ecstoneusps/Claude-gadget/sdcard/settings.txt

# Desk Buddy settings
#
# Edit this file on your computer, put the card back in, and restart the
# buddy (or unplug it and plug it back in). Anything after # is a comment.
# Delete a line, or the whole file, to go back to the built-in default.
# Mistakes are shown in the serial log and that line is ignored.

# --- Sound and screen ---
volume                       = 63     # speaker volume, 0-100 ("be quiet" still mutes it)
sound_style                  = puppy  # puppy (yips, barks, panting) or robot (chirps, boops); sounds/<name>.wav on the card replaces one
brightness                   = 63     # screen brightness, 0-100
screen_flip                  = on     # on: CoreS3 turned around in the puppy head (camera at the top)
dim_brightness               = 8      # brightness while dozing, 0-100

# --- Sleepiness ---
sleep_after_seconds          = 60     # doze off after this long with nothing happening
dim_after_seconds            = 180    # dim the screen after this long
sleep_after_leaving_seconds  = 20     # doze sooner once you walk away

# --- Voice ---
command_confidence           = 0      # 0-1; raise to 0.3 or so if it reacts to things you didn't say
two_microphones              = off    # both mics: hears you better over noise, but slows everything else down

# Extra ways to say a command, separated by commas. Letters and spaces only.
# Remove the # in front of a line to use it. Commands you can add to:
#  say.hello  say.good_night  say.wake_up  say.how_are_you  say.i_love_you
#  say.good_job  say.scold  say.thank_you  say.tell_joke  say.look_left
#  say.look_right  say.be_happy  say.be_sad  say.be_angry  say.be_surprised
#  say.be_quiet  say.sound_on  say.wink  say.be_cool  say.be_silly
#  say.volume_up  say.volume_down  say.take_picture  say.look_at_this
# say.hello = howdy, whats up buddy
# say.good_night = nighty night

# --- Camera ---
face_tracking                = on     # eyes follow your face
camera_mirrored              = off    # flip (on/off) if the eyes look away from you instead of at you
face_gaze                    = 1.4    # how far the eyes turn toward you, 0-3
face_model                   = fast   # fast checks ~14 times a second; accurate finds you more often per check but is ~7x slower
photo_flash                  = off    # screen lights up white for photos (brighter close-ups; shiny things reflect)
camera_preview               = off    # show what the camera sees (green box = face found) instead of the face

# --- Proximity sensor (above the screen) ---
proximity                    = on     # wake up when you sit down
proximity_sensitivity        = 25     # lower notices you from further away (but more false alarms)

# --- Presence radar (LD2410, plugged into Port C) ---
radar                        = on     # use the radar when one is plugged in (instead of the proximity sensor)
radar_distance_cm            = 150    # how close (cm) counts as sitting at the desk, 30-600

# --- Motion ---
flip_tilt_x                  = off    # turn on if tilting left/right makes the eyes go the wrong way
flip_tilt_y                  = off    # same for tilting forward/back

# --- Talking with the AI (through Home Assistant) ---
# Fill in all four to talk to Buddy's AI. Put "quotes" around the password
# if it has a # in it. Keep this card private: the token is a password.
wifi_name                    =        # your home Wi-Fi network (2.4 GHz)
wifi_password                =        # its password
wifi_name_2                  =        # optional: another network if home isn't in range, e.g. your phone's hotspot
wifi_password_2              =        # its password
wifi_name_3                  =        # optional: a third network, tried after the second
wifi_password_3              =        # its password
setup_hotspot                = on     # no network works for 2 min: open Wi-Fi "Buddy Setup" for the settings page
ha_url                       =        # Home Assistant's address at home, e.g. http://192.168.1.20:8123
ha_url_away                  =        # optional: its address from anywhere else, e.g. a Tailscale Funnel https://...ts.net
ha_token                     =        # long-lived access token (from the Desk Buddy user)
ha_pipeline                  = Buddy  # name of the voice assistant in Home Assistant
conversation                 = on     # off = only the built-in commands
follow_up                    = on     # keep listening after an answer, no "Hey Buddy" needed
memory                       = on     # "remember that ..." notes, kept in memories.txt and told to the AI
learn                        = on     # after a chat, the AI adds lasting facts it heard to memories.txt (check them on the settings page)
voice_id_url                 =        # optional: voice recognition on the PC (tools/voiceid), e.g. http://192.168.1.30:8095
welcome_back_minutes         = 20     # say hello out loud when you come back after this long away (0 = off)

# --- Home Assistant sensors and controls (MQTT, through the Mosquitto add-on) ---
# Buddy shows up in Home Assistant as the device "Desk Buddy": at desk, light level,
# mood..., plus volume, "say" and more. Home network only.
mqtt_url                     =        # the broker, e.g. mqtt://192.168.1.20:1883 (Home Assistant's address)
mqtt_user                    =        # an MQTT login (a Home Assistant user works)
mqtt_password                =        # its password

# --- Seeing ("what do you see?", "what am I holding?") ---
# Photos go straight to a vision model in Ollama on your PC; the answer is
# spoken through Home Assistant. Install it first: ollama pull gemma3:4b
vision_url                   =        # Ollama's address, e.g. http://192.168.1.30:11434
vision_model                 = gemma3:4b # a vision model you've pulled in Ollama
