ecstoneusps/Claude-gadget/hardware/puppy/images/paws.png

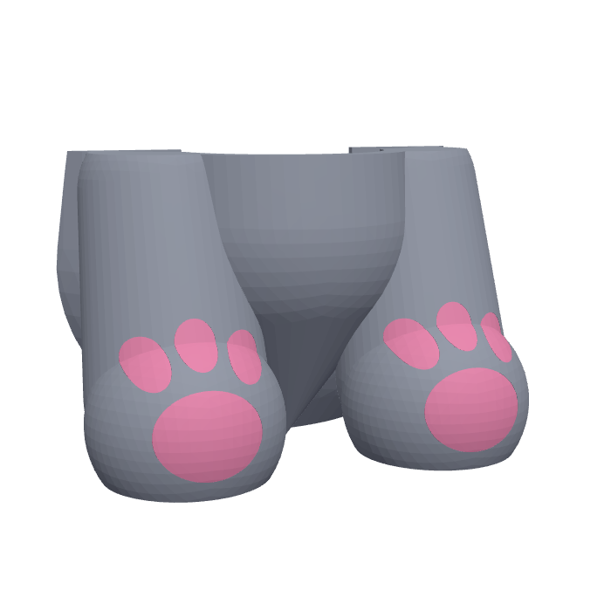
hardware/puppy/images/paws.png
