ecstoneusps/Claude-gadget/preview/face_anim.gif

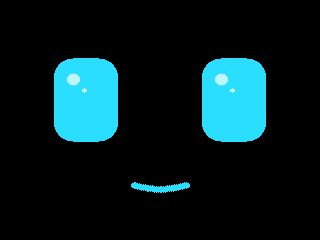
preview/face_anim.gif
