ecstoneusps/Claude-gadget/hardware/puppy/stl/buddy_body.stl

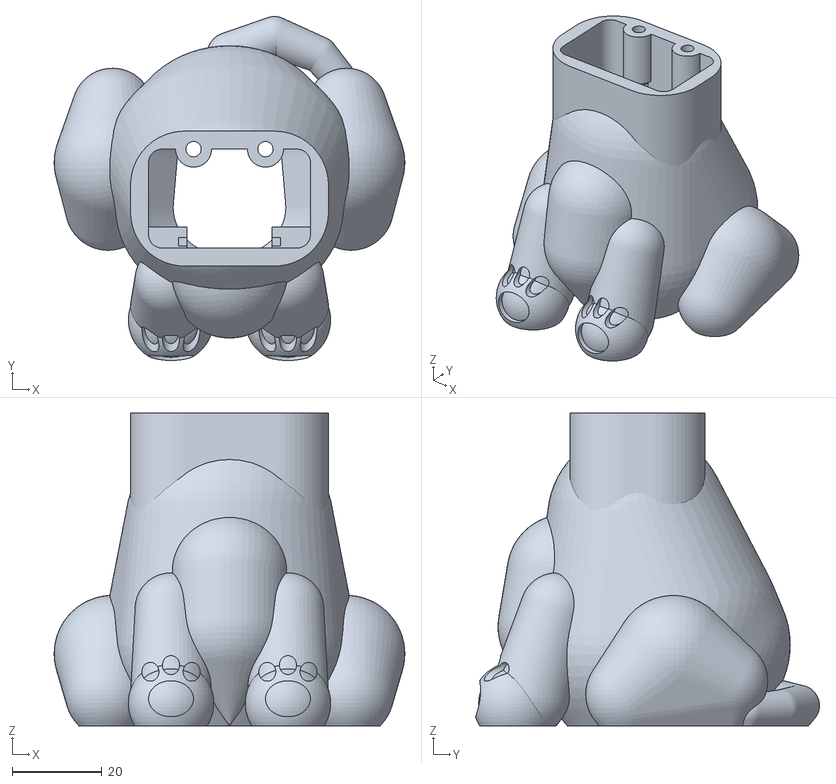
[picture p9: CAD file, 2026-11-09]
hardware/puppy/stl/buddy_body.stl
78.0 x 76.5 x 69.5
