ecstoneusps/Claude-gadget/hardware/puppy/stl/buddy_back_cap.stl

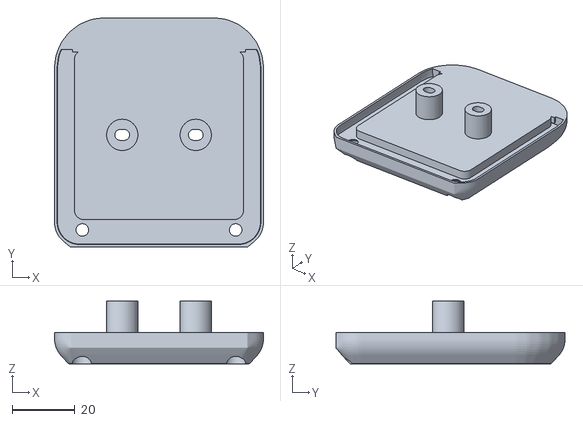
[picture p10: CAD file, 2026-11-09]
hardware/puppy/stl/buddy_back_cap.stl
66.8 x 73.3 x 20.0
