ecstoneusps/Claude-gadget/hardware/puppy/stl/buddy_body_pink.stl

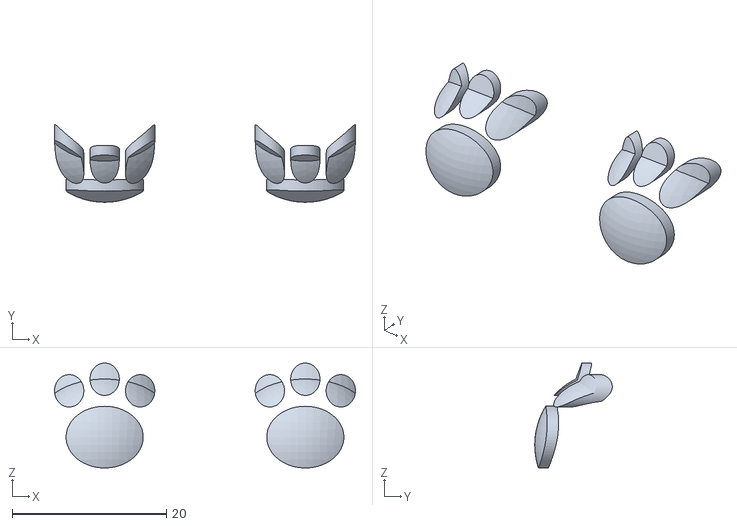
[picture p11: CAD file, 2026-11-09]
hardware/puppy/stl/buddy_body_pink.stl
39.0 x 10.1 x 13.6
