ecstoneusps/Claude-gadget/hardware/puppy/stl/buddy_head.stl

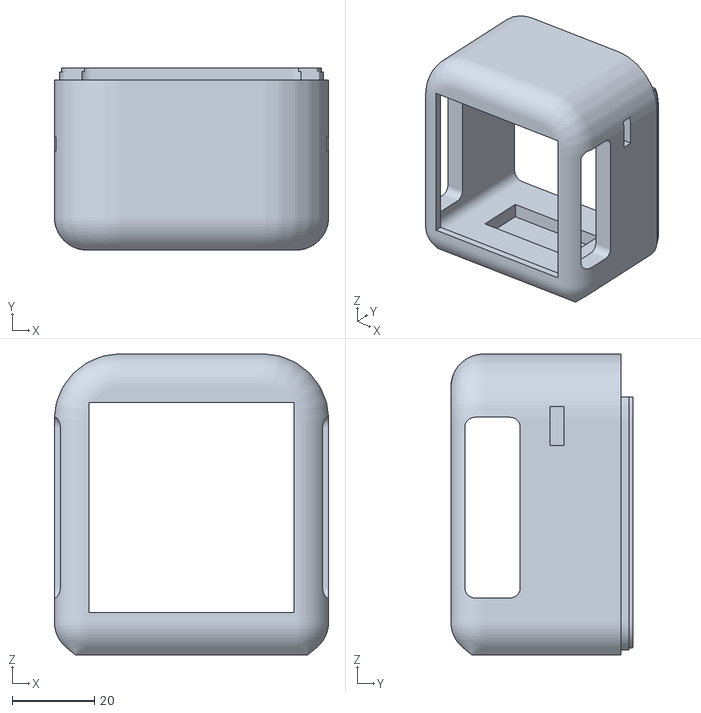
[picture p12: CAD file, 2026-11-09]
hardware/puppy/stl/buddy_head.stl
66.8 x 44.4 x 73.3
