ecstoneusps/Claude-gadget/hardware/puppy/stl/buddy_ear_left.stl

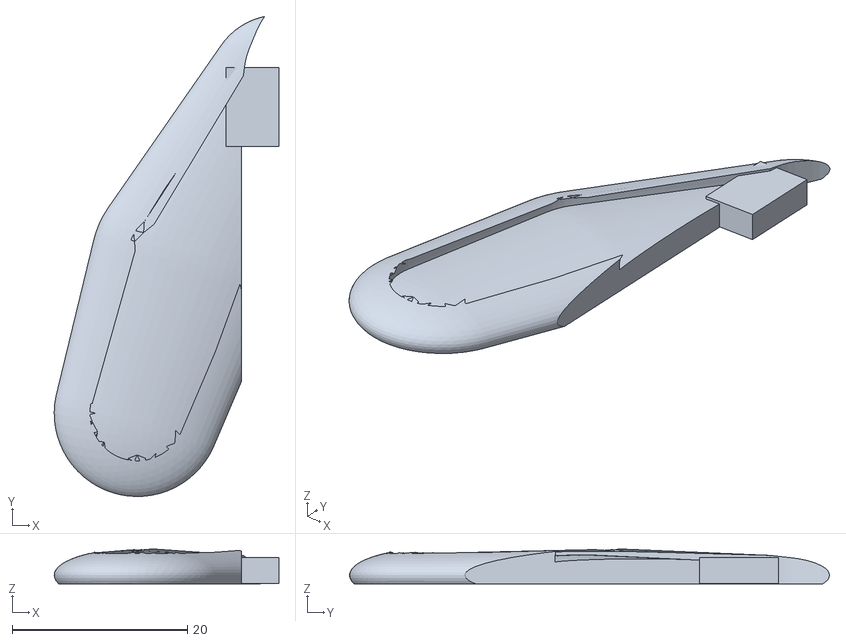
[picture p13: CAD file, 2026-11-09]
hardware/puppy/stl/buddy_ear_left.stl
25.6 x 54.8 x 3.99
