ecstoneusps/Claude-gadget/hardware/puppy/stl/buddy_ear_right.stl

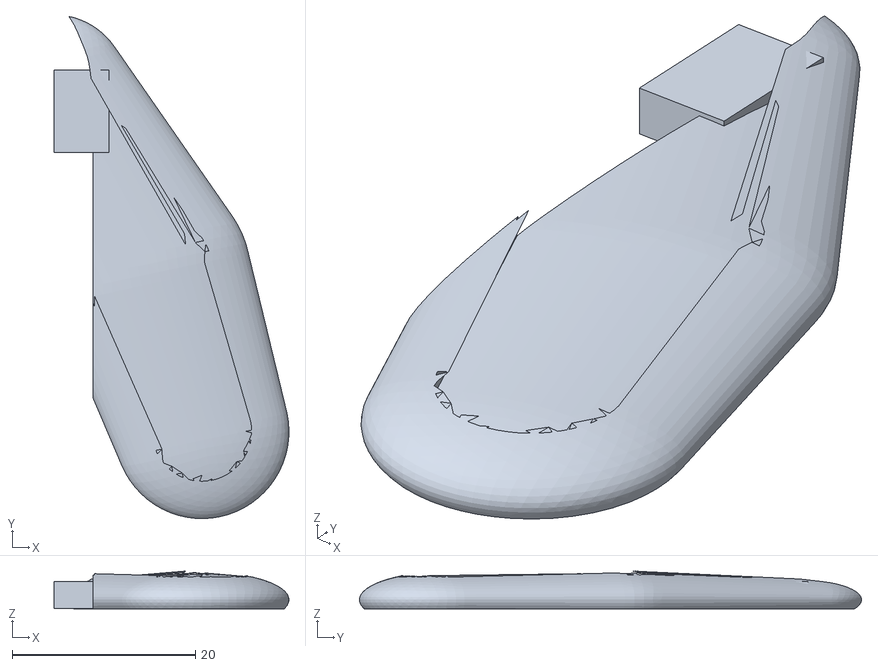
[picture p14: CAD file, 2026-11-09]
hardware/puppy/stl/buddy_ear_right.stl
25.6 x 54.8 x 4.13
