ecstoneusps/Claude-gadget/hardware/puppy/stl/buddy_ear_right_pink.stl

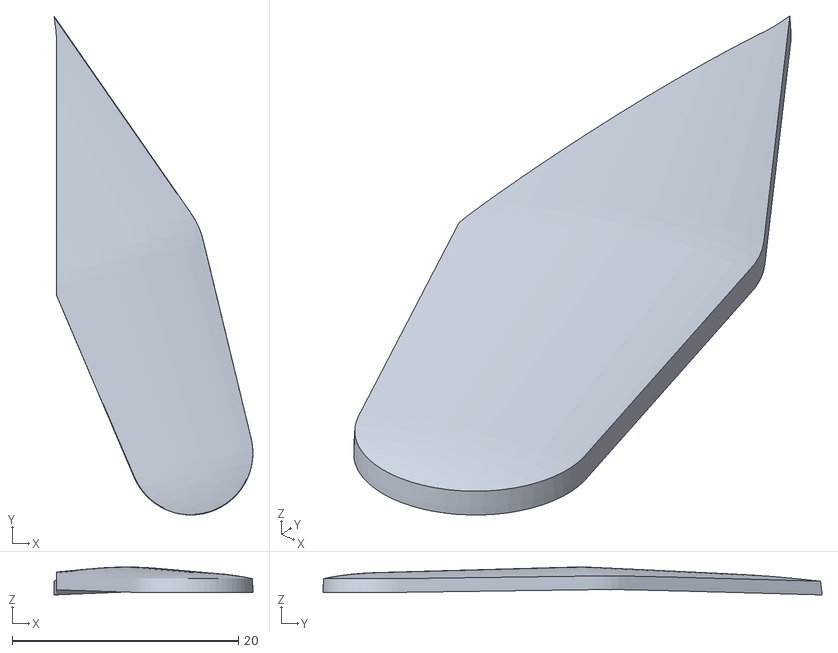
[picture p15: CAD file, 2026-11-09]
hardware/puppy/stl/buddy_ear_right_pink.stl
17.6 x 44.1 x 2.47
