ecstoneusps/Claude-gadget/(list of files, cad)

Other CAD files:
hardware/puppy/stl/buddy_ear_left_pink.stl
