ecstoneusps/Claude-gadget/main/camera.cpp

#include "camera.h"

#include <atomic>

#include <M5Unified.h>
#include "esp_camera.h"
#include "esp_log.h"
#include "esp_timer.h"
#include "esp_heap_caps.h"
#include "freertos/semphr.h"
#include <string.h>
#include "freertos/FreeRTOS.h"
#include "freertos/task.h"
#include "freertos/idf_additions.h"

#include "human_face_detect.hpp"
#include "img_converters.h"
#include "i2c_bus.h"

static const char* TAG = "camera";

// GC0308 wiring on the CoreS3, from M5Stack's CoreS3 library
// (github.com/m5stack/M5CoreS3, src/utility/GC0308.cpp).
static camera_config_t makeConfig(framesize_t size = FRAMESIZE_QQVGA, int fbCount = 2) {
    camera_config_t c = {};
    c.pin_pwdn = -1;
    c.pin_reset = -1;
    c.pin_xclk = -1;  // the CoreS3 clocks the sensor itself
    c.pin_sccb_sda = -1;  // -1: reuse the already-open internal I2C bus (see i2c_bus.h)
    c.pin_sccb_scl = -1;
    c.pin_d7 = 47;
    c.pin_d6 = 48;
    c.pin_d5 = 16;
    c.pin_d4 = 15;
    c.pin_d3 = 42;
    c.pin_d2 = 41;
    c.pin_d1 = 40;
    c.pin_d0 = 39;
    c.pin_vsync = 46;
    c.pin_href = 38;
    c.pin_pclk = 45;
    c.xclk_freq_hz = 20000000;
    c.ledc_timer = LEDC_TIMER_0;
    c.ledc_channel = LEDC_CHANNEL_0;
    c.pixel_format = PIXFORMAT_RGB565;
    c.frame_size = size;  // QQVGA 160x120 for tracking (full field of view, subsample mode); VGA for photos
    c.jpeg_quality = 0;
    c.fb_count = fbCount;
    c.fb_location = CAMERA_FB_IN_PSRAM;
    // Always hand face detection the newest frame. (Capturing only on request
    // gave it stale frames, so it lagged far behind someone moving.)
    c.grab_mode = CAMERA_GRAB_LATEST;
    c.sccb_i2c_port = 1;
    return c;
}

// esp32-camera delivers RGB565 high byte first.
static constexpr dl::image::pix_type_t kPixType = dl::image::DL_IMAGE_PIX_TYPE_RGB565BE;

static portMUX_TYPE s_lock = portMUX_INITIALIZER_UNLOCKED;
static FaceSighting s_latest = {};
static std::atomic<uint32_t> s_intervalMs{200};
static bool s_cameraOk = false;            // started for face tracking / preview
static bool s_flip = false;                // turn the picture 180 degrees (screen_flip)

void cameraSetFlip(bool turned) { s_flip = turned; }

// Turning the picture 180 degrees is mirroring it both ways. The driver reads
// the sensor's current mirror/flip bits at start, so toggle them.
static void applyFlip(sensor_t* s) {
    if (!s_flip || !s) return;
    if (s->set_hmirror) s->set_hmirror(s, !s->status.hmirror);
    if (s->set_vflip) s->set_vflip(s, !s->status.vflip);
}
static std::atomic<bool> s_hold{false};    // face task: stop touching the camera (a photo is being taken)
static std::atomic<bool> s_held{false};    // face task: ...and it has stopped
static uint16_t* s_preview = nullptr;      // latest frame copy, only in preview mode
static uint32_t s_previewSeq = 0;
static SemaphoreHandle_t s_previewLock = nullptr;

void cameraEnablePreview() {
    if (s_preview) return;
    s_preview = (uint16_t*)heap_caps_malloc(kCamW * kCamH * 2, MALLOC_CAP_SPIRAM);
    s_previewLock = xSemaphoreCreateMutex();
}

bool cameraCopyPreview(uint16_t* dst, uint32_t* seq) {
    if (!s_preview || !s_previewLock) return false;
    bool fresh = false;
    if (xSemaphoreTake(s_previewLock, pdMS_TO_TICKS(5)) == pdTRUE) {
        if (s_previewSeq != *seq) {
            memcpy(dst, s_preview, kCamW * kCamH * 2);
            *seq = s_previewSeq;
            fresh = true;
        }
        xSemaphoreGive(s_previewLock);
    }
    return fresh;
}

bool cameraBegin() {
    // The camera's control bus (SCCB) is the CoreS3's internal I2C bus, shared
    // with M5Unified and the audio chips through one ESP-IDF bus handle.
    if (!sharedI2cBus()) return false;
    camera_config_t cfg = makeConfig();
    esp_err_t err = esp_camera_init(&cfg);
    if (err != ESP_OK) {
        ESP_LOGW(TAG, "camera init failed (%s); face tracking disabled", esp_err_to_name(err));
        return false;
    }
    if (sensor_t* s = esp_camera_sensor_get()) {
        // Brightest auto-exposure target: indoors the default image is dark
        // (mean green ~8/63 measured), which made faces hard to find.
        if (s->set_ae_level) s->set_ae_level(s, 2);
        applyFlip(s);
        ESP_LOGI(TAG, "camera ready (sensor PID 0x%02x)", s->id.PID);
    }
    s_cameraOk = true;
    return true;
}

// Brightens a dark big-endian RGB565 frame in place toward a mid-level mean,
// so the face model (trained on normally exposed photos) sees contrast.
// Returns the mean green level (0-63) before brightening.
static int autoBrighten(uint8_t* px, size_t pixels) {
    uint32_t sum = 0, count = 0;
    for (size_t i = 0; i < pixels; i += 7, ++count) sum += ((px[2 * i] << 8 | px[2 * i + 1]) >> 5) & 0x3F;
    const int mean = count ? (int)(sum / count) : 0;
    constexpr int kTarget = 28;  // about 45% brightness
    if (mean <= 0 || mean >= kTarget) return mean;
    int gain256 = kTarget * 256 / mean;  // fixed point
    if (gain256 > 4 * 256) gain256 = 4 * 256;
    for (size_t i = 0; i < pixels; ++i) {
        const uint16_t v = (uint16_t)(px[2 * i] << 8 | px[2 * i + 1]);
        int r = ((v >> 11) & 0x1F) * gain256 >> 8;
        int g = ((v >> 5) & 0x3F) * gain256 >> 8;
        int b = (v & 0x1F) * gain256 >> 8;
        if (r > 31) r = 31;
        if (g > 63) g = 63;
        if (b > 31) b = 31;
        const uint16_t o = (uint16_t)(r << 11 | g << 5 | b);
        px[2 * i] = o >> 8;
        px[2 * i + 1] = o & 0xFF;
    }
    return mean;
}

static void faceTask(void* arg) {
    const bool accurate = arg != nullptr;
    // Hardware test: MSR+MNP found a face in only 14-20% of frames even in
    // bright light; ESPDet-Pico has a much higher published accuracy (mAP
    // 0.504 vs 0.367).
    HumanFaceDetect* detector = new HumanFaceDetect(
        accurate ? HumanFaceDetect::ESPDET_PICO_224_224_FACE : HumanFaceDetect::MSRMNP_S8_V1, false);
    ESP_LOGI(TAG, "face detection model loaded: %s", accurate ? "ESPDet-Pico 224 (accurate)" : "MSR+MNP (fast)");
    uint32_t seq = 0, logged = 0;
    uint32_t hits = 0, tries = 0;    // detection hit rate, for the status line
    TickType_t lastHit = 0;

    while (true) {
        if (s_hold.load()) {
            s_held.store(true);
            vTaskDelay(pdMS_TO_TICKS(50));
            continue;
        }
        s_held.store(false);
        const uint32_t interval = s_intervalMs.load();
        if (interval == 0) {
            vTaskDelay(pdMS_TO_TICKS(250));
            continue;
        }
        const TickType_t start = xTaskGetTickCount();

        camera_fb_t* fb = esp_camera_fb_get();
        if (!fb) {
            vTaskDelay(pdMS_TO_TICKS(100));
            continue;
        }
        const int rawBrightness = autoBrighten(fb->buf, (size_t)fb->width * fb->height);
        dl::image::img_t img = {fb->buf, (uint16_t)fb->width, (uint16_t)fb->height, kPixType};
        const int64_t t0 = esp_timer_get_time();
        std::list<dl::detect::result_t>& results = detector->run(img);
        const int detectMs = (int)((esp_timer_get_time() - t0) / 1000);

        FaceSighting f = {};
        f.seq = ++seq;
        int bestArea = 0;
        for (const auto& r : results) {
            const int w = r.box[2] - r.box[0], h = r.box[3] - r.box[1];
            if (w * h <= bestArea) continue;  // the biggest face is probably you
            bestArea = w * h;
            f.found = true;
            f.x = ((r.box[0] + r.box[2]) * 0.5f / fb->width) * 2.0f - 1.0f;
            f.y = ((r.box[1] + r.box[3]) * 0.5f / fb->height) * 2.0f - 1.0f;
            f.size = (float)h / fb->height;
            for (int k = 0; k < 4; ++k) f.box[k] = r.box[k];
        }
        ++tries;
        if (f.found) {
            ++hits;
            lastHit = xTaskGetTickCount();
        }
        if (s_preview && fb->len >= (size_t)kCamW * kCamH * 2 &&
            xSemaphoreTake(s_previewLock, pdMS_TO_TICKS(20)) == pdTRUE) {
            memcpy(s_preview, fb->buf, kCamW * kCamH * 2);
            ++s_previewSeq;
            xSemaphoreGive(s_previewLock);
        }
        // Every ~10 s, a status line whether or not a face was found: detection
        // time, hit rate and the camera's raw brightness (mean green, 0-63).
        if (seq % 50 == 1) {
            ESP_LOGI(TAG, "frame %ux%u, detect %d ms, face found in %u of %u frames; brightness %d/63 (boosted for detection)",
                     fb->width, fb->height, detectMs, (unsigned)hits, (unsigned)tries, rawBrightness);
            hits = tries = 0;
        }
        esp_camera_fb_return(fb);

        taskENTER_CRITICAL(&s_lock);
        s_latest = f;
        taskEXIT_CRITICAL(&s_lock);

        // Log now and then so the direction and range can be checked.
        if (f.found && seq - logged >= 25) {
            logged = seq;
            ESP_LOGI(TAG, "face at x=%+.2f y=%+.2f size=%.2f", f.x, f.y, f.size);
        }

        // Just lost you (seen in the last 2 s)? You probably moved and the
        // frame blurred: look again right away instead of waiting a full
        // interval. With nobody there, it settles back to the normal rate.
        const TickType_t now = xTaskGetTickCount();
        const bool justLost = !f.found && lastHit && now - lastHit < pdMS_TO_TICKS(2000);
        const TickType_t elapsed = now - start;
        const TickType_t wait = pdMS_TO_TICKS(justLost ? 60 : interval);
        // Always rest at least half as long as the detection took. The
        // accurate model takes ~0.5 s, and running it back to back left core 0
        // no idle time at all (task watchdog warnings).
        TickType_t rest = elapsed < wait ? wait - elapsed : 1;
        if (rest < elapsed / 2) rest = elapsed / 2;
        vTaskDelay(rest);
    }
}

void faceTrackingStart(bool accurate) {
    if (!s_cameraOk) return;
    // Core 0, below the mic front-end (priority 5). Core 1 carries wake word +
    // commands, drawing and sound; at the lowest priority there, detection
    // was starved and only caught a face if you held still.
    // 12 KB stack in PSRAM: internal RAM is needed by Wi-Fi.
    xTaskCreatePinnedToCoreWithCaps(faceTask, "face", 12 * 1024, accurate ? (void*)1 : nullptr, 3, nullptr, 0,
                                    MALLOC_CAP_SPIRAM);
}

void faceTrackingSetInterval(uint32_t ms) { s_intervalMs.store(ms); }

FaceSighting faceTrackingLatest() {
    taskENTER_CRITICAL(&s_lock);
    FaceSighting f = s_latest;
    taskEXIT_CRITICAL(&s_lock);
    return f;
}

// ---------------------------------------------------------------------------
// Photos: the camera is started at 320x240 only while a photo is being taken.

static bool s_photoOn = false;
static bool s_photoPausedTracking = false;

static void startCamera(framesize_t size, int fbCount) {
    // Always the normal mode (through the small internal DMA buffer). The
    // "DMA straight into PSRAM" mode delivered frames at 640x480 but with
    // whole strips missing or filled with old memory (hardware test, with
    // and without a slower pixel clock).
    esp_camera_set_psram_mode(false);
    camera_config_t cfg = makeConfig(size, fbCount);
    esp_err_t err = esp_camera_init(&cfg);
    if (err != ESP_OK) {
        ESP_LOGW(TAG, "camera start failed (%s)", esp_err_to_name(err));
        return;
    }
    if (sensor_t* sen = esp_camera_sensor_get()) {
        if (sen->set_ae_level) sen->set_ae_level(sen, 2);
        applyFlip(sen);
        if (size != FRAMESIZE_QQVGA && sen->set_reg) {
            // Slow the sensor's pixel clock (GC0308 register 0x28, bits 6:4 =
            // divider - 1; the driver uses 1 on the original ESP32). A photo
            // frame is 4x the data of a tracking frame, and the small DMA
            // buffer must keep up: /4 gives it the same data rate as tracking.
            sen->set_reg(sen, 0xfe, 0xff, 0x00);  // register page 0
            sen->set_reg(sen, 0x28, 0x70, 0x30);
            if (sen->get_reg) ESP_LOGI(TAG, "pixel clock divider register 0x28 = 0x%02x", sen->get_reg(sen, 0x28, 0xff));
        }
    }
    if (size != FRAMESIZE_QQVGA) s_photoOn = true;
}

// A frame if one is ready within `waitMs`, without blocking longer (the
// driver's own wait is 4 s, which froze the screen).
static camera_fb_t* frameWithin(uint32_t waitMs) {
    for (uint32_t waited = 0; !esp_camera_available_frames(); waited += 10) {
        if (waited >= waitMs) return nullptr;
        vTaskDelay(pdMS_TO_TICKS(10));
    }
    return esp_camera_fb_get();
}

bool photoBegin() {
    if (s_photoOn) return true;
    if (!sharedI2cBus()) return false;
    if (s_cameraOk) {
        // Face tracking has the camera at 160x120: pause it and restart larger.
        s_hold.store(true);
        for (int i = 0; i < 60 && !s_held.load(); ++i) vTaskDelay(pdMS_TO_TICKS(25));
        esp_camera_deinit();
        s_photoPausedTracking = true;
    }
    // 320x240: the screen's size, and what the camera delivers cleanly (see
    // startCamera). Two buffers so the live view always shows the newest frame.
    startCamera(FRAMESIZE_QVGA, 2);
    if (!s_photoOn) {
        if (s_photoPausedTracking) {
            startCamera(FRAMESIZE_QQVGA, 2);
            s_photoPausedTracking = false;
            s_hold.store(false);
        }
        return false;
    }
    return true;
}

// Screen-size copy of a frame (640x480: every other pixel and row; 320x240:
// as is), still big-endian RGB565, brightened like the face detector's frames.
static bool toScreen(const camera_fb_t* fb, uint16_t* dst) {
    const int step = fb->width / kPhotoW;
    if (step < 1 || fb->width != kPhotoW * step || fb->height != kPhotoH * step) return false;
    const uint16_t* src = (const uint16_t*)fb->buf;
    for (int y = 0; y < kPhotoH; ++y) {
        const uint16_t* row = src + (step * y) * fb->width;
        uint16_t* out = dst + y * kPhotoW;
        for (int x = 0; x < kPhotoW; ++x) out[x] = row[step * x];
    }
    autoBrighten((uint8_t*)dst, (size_t)kPhotoW * kPhotoH);
    return true;
}

bool photoPreview(uint16_t* dst) {
    if (!s_photoOn || !esp_camera_available_frames()) return false;  // never wait: the screen keeps drawing
    camera_fb_t* fb = esp_camera_fb_get();
    if (!fb) return false;
    const bool ok = toScreen(fb, dst);
    esp_camera_fb_return(fb);
    return ok;
}

bool photoCapture(uint8_t** jpeg, size_t* len, uint16_t* still, bool fresh) {
    *jpeg = nullptr;
    *len = 0;
    if (!s_photoOn) return false;
    if (fresh) {
        // Frames waiting in the buffers were taken before the flash, and the
        // next one may have started before it (half lit): skip them all.
        while (esp_camera_available_frames())
            if (camera_fb_t* old = esp_camera_fb_get()) esp_camera_fb_return(old);
        if (camera_fb_t* half = frameWithin(1000)) esp_camera_fb_return(half);
    }
    // The live view keeps taking frames, so the next one is fresh.
    camera_fb_t* fb = frameWithin(1500);
    if (!fb) {
        ESP_LOGW(TAG, "photo: no frame from the camera");
        return false;
    }
    if (still) toScreen(fb, still);
    const int64_t t0 = esp_timer_get_time();
    const int mean = autoBrighten(fb->buf, (size_t)fb->width * fb->height);
    const bool ok = frame2jpg(fb, 80, jpeg, len);
    ESP_LOGI(TAG, "photo %ux%u: %u KB JPEG in %d ms (brightness %d/63 before boosting)", fb->width, fb->height,
             (unsigned)(*len / 1024), (int)((esp_timer_get_time() - t0) / 1000), mean);
    esp_camera_fb_return(fb);
    return ok;
}

void photoEnd() {
    if (!s_photoOn) return;
    esp_camera_deinit();
    s_photoOn = false;
    if (s_photoPausedTracking) {
        startCamera(FRAMESIZE_QQVGA, 2);
        s_photoPausedTracking = false;
        s_hold.store(false);
    }
}
