ecstoneusps/Claude-gadget/main/sound.cpp

#include "sound.h"

#include <atomic>
#include <math.h>
#include <string>
#include <vector>

#include "esp_heap_caps.h"
#include "esp_log.h"
#include "esp_timer.h"
#include "freertos/FreeRTOS.h"
#include "freertos/task.h"
#include "freertos/idf_additions.h"
#include "freertos/stream_buffer.h"

#include "Wav.h"
#include "audio_io.h"
#include "sdcard.h"

static const char* TAG = "sound";

static_assert(kSfxSampleRate == kAudioSampleRate, "effects must be rendered at the I2S rate");

static int16_t* s_pcm[(int)Sfx::Count];
static size_t s_len[(int)Sfx::Count];

static TaskHandle_t s_player = nullptr;
static std::atomic<int> s_request{(int)Sfx::None};
static std::atomic<bool> s_playing{false};
static std::atomic<int64_t> s_lastSoundUs{0};

static StreamBufferHandle_t s_speechBuf = nullptr;
static std::atomic<bool> s_speechStart{false};  // a reply began; the player should pick it up
static std::atomic<bool> s_speechOpen{false};   // more pieces may still come
static std::atomic<bool> s_speaking{false};
static std::atomic<bool> s_stopSpeech{false};
static std::atomic<float> s_speechLevel{0};
static std::atomic<float> s_effectLevel{0};

// Loudness of a chunk mapped to 0..1 mouth opening (-42 dBFS closed, -12 wide open).
static float chunkLevel(const int16_t* p, int n) {
    double sum = 0;
    for (int i = 0; i < n; ++i) sum += (double)p[i] * p[i];
    const double rms = sqrt(sum / (n > 0 ? n : 1)) / 32768.0;
    const float db = rms > 1e-6 ? 20.0f * log10f((float)rms) : -120.0f;
    const float l = (db + 42.0f) / 30.0f;
    return l < 0 ? 0 : l > 1 ? 1 : l;
}

static bool playSpeech() {
    if (!s_speechStart.exchange(false)) return false;
    s_playing.store(true);
    int16_t buf[256];  // 16 ms
    while (!s_stopSpeech.load()) {
        const size_t got = xStreamBufferReceive(s_speechBuf, buf, sizeof buf, pdMS_TO_TICKS(20));
        if (got == 0) {
            if (!s_speechOpen.load() && xStreamBufferIsEmpty(s_speechBuf)) break;  // all played
            s_speechLevel.store(0);  // waiting for more (the speaker plays silence meanwhile)
            continue;
        }
        const int n = (int)(got / sizeof(int16_t));
        s_speechLevel.store(chunkLevel(buf, n));
        audioWrite(buf, n);
        s_lastSoundUs.store(esp_timer_get_time());
    }
    s_speechLevel.store(0);
    s_speaking.store(false);
    return true;
}

// Streams the requested sound in short chunks, so a newer request cuts in
// within a few milliseconds instead of waiting for the old sound to end.
static void playerTask(void*) {
    constexpr int kChunk = 256;  // 16 ms
    while (true) {
        ulTaskNotifyTake(pdTRUE, portMAX_DELAY);
        if (playSpeech()) s_request.store((int)Sfx::None);  // effects asked for during speech are dropped
        int req;
        while ((req = s_request.exchange((int)Sfx::None)) != (int)Sfx::None) {
            s_playing.store(true);
            const int16_t* pcm = s_pcm[req];
            size_t left = s_len[req];
            while (left > 0 && s_request.load() == (int)Sfx::None && !s_speechStart.load()) {
                const int n = left < (size_t)kChunk ? (int)left : kChunk;
                s_effectLevel.store(chunkLevel(pcm, n));
                audioWrite(pcm, n);
                pcm += n;
                left -= n;
                s_lastSoundUs.store(esp_timer_get_time());
            }
        }
        s_effectLevel.store(0);
        playSpeech();  // a reply that arrived during an effect
        s_playing.store(false);
        s_lastSoundUs.store(esp_timer_get_time());
    }
}

// sounds/<name>.wav on the SD card (any rate, mono or stereo, 16-bit)
// replaces a built-in sound.
static bool loadFromCard(Sfx s) {
    const std::string path = std::string("sounds/") + sfxName(s) + ".wav";
    std::vector<uint8_t> file;
    if (!sdcardReadBinary(path.c_str(), file, 2 * 1024 * 1024)) return false;
    WavInfo info;
    if (!parseWav(file.data(), file.size(), info)) {
        ESP_LOGW(TAG, "%s isn't a 16-bit PCM WAV; using the built-in sound", path.c_str());
        return false;
    }
    const size_t n = wavResampledLength(info, kAudioSampleRate);
    int16_t* pcm = (int16_t*)heap_caps_malloc(n * sizeof(int16_t) + 2, MALLOC_CAP_SPIRAM);
    if (!pcm) return false;
    s_len[(int)s] = wavToMono(file.data(), info, kAudioSampleRate, pcm, n);
    s_pcm[(int)s] = pcm;
    ESP_LOGI(TAG, "using %s (%.1f s)", path.c_str(), s_len[(int)s] / (float)kAudioSampleRate);
    return true;
}

void soundInit() {
    size_t total = 0;
    for (int i = 1; i < (int)Sfx::Count; ++i) {
        const Sfx s = (Sfx)i;
        if (loadFromCard(s)) {
            total += s_len[i] * sizeof(int16_t);
            continue;
        }
        s_len[i] = sfxSamples(s);
        s_pcm[i] = (int16_t*)heap_caps_malloc(s_len[i] * sizeof(int16_t), MALLOC_CAP_SPIRAM);
        if (!s_pcm[i]) {
            ESP_LOGE(TAG, "out of memory rendering %s", sfxName(s));
            s_len[i] = 0;
            continue;
        }
        sfxRender(s, s_pcm[i]);
        total += s_len[i] * sizeof(int16_t);
    }
    s_speechBuf = xStreamBufferCreateWithCaps(kAudioSampleRate * 2 * 8, 2, MALLOC_CAP_SPIRAM);  // 8 s
    // Core 1 next to the UI; it mostly waits on the I2S DMA.
    xTaskCreatePinnedToCore(playerTask, "sound", 3072, nullptr, 5, &s_player, 1);
    ESP_LOGI(TAG, "%s sounds ready, %u KB", sfxStyle() == SfxStyle::Puppy ? "puppy" : "robot", (unsigned)(total / 1024));
}

void soundSetVolume(int percent) { audioSetVolume(percent); }

void soundPlay(Sfx s) {
    if (s == Sfx::None || s_len[(int)s] == 0 || !s_player || s_speaking.load()) return;
    s_request.store((int)s);
    xTaskNotifyGive(s_player);
}

bool soundHeardRecently(uint32_t tailMs) {
    return s_playing.load() || esp_timer_get_time() - s_lastSoundUs.load() < (int64_t)tailMs * 1000;
}

void soundSpeechBegin() {
    if (!s_player || !s_speechBuf) return;
    // The previous reply has finished (callers wait for soundSpeaking() to
    // go false), so nothing is blocked on the buffer and it can be reset.
    s_stopSpeech.store(false);
    xStreamBufferReset(s_speechBuf);
    s_speechOpen.store(true);
    s_speaking.store(true);
    s_speechStart.store(true);
    xTaskNotifyGive(s_player);
}

void soundSpeechWrite(const int16_t* pcm, size_t samples) {
    if (!s_speechBuf || !s_speechOpen.load()) return;
    const uint8_t* p = (const uint8_t*)pcm;
    size_t left = samples * sizeof(int16_t);
    while (left > 0 && !s_stopSpeech.load()) {
        const size_t sent = xStreamBufferSend(s_speechBuf, p, left, pdMS_TO_TICKS(100));
        p += sent;
        left -= sent;
    }
}

void soundSpeechEnd() { s_speechOpen.store(false); }

size_t soundSpeechQueued() {
    return s_speechBuf ? xStreamBufferBytesAvailable(s_speechBuf) / sizeof(int16_t) : 0;
}

void soundStopSpeech() {
    s_speechOpen.store(false);
    if (s_speaking.load()) s_stopSpeech.store(true);
}

bool soundSpeaking() { return s_speaking.load(); }
float soundSpeechLevel() { return s_speechLevel.load(); }

float soundEffectLevel() { return s_effectLevel.load(); }
