ecstoneusps/Claude-gadget/main/assistant.h

#pragma once
#include <stdint.h>
#include <string>
#include <utility>
#include <vector>
#include "freertos/FreeRTOS.h"
#include "freertos/queue.h"

#include "Companion.h"  // VoiceCommand

// Talking with an AI through Home Assistant's voice assistant ("Assist").
//
// After "Hey Buddy", voice.cpp streams what you say here. This sends it over
// Home Assistant's websocket API to its speech-to-text (Whisper). If the words
// are one of the buddy's own action commands ("look left", "wink at me") it
// does that itself; anything else goes to the conversation agent (the AI on
// Ollama). The reply's emotion tag sets the face, and the rest is turned into
// speech (Piper) and played with the mouth moving along.

struct AssistantConfig {
    std::string url;       // http://192.168.1.20:8123 (on the home network, the first Wi-Fi)
    std::string urlAway;   // on any other network ("" = url), e.g. https://homeassistant.tailnet.ts.net
    bool firstNetworkIsHome = true;  // false: only extra networks (wifi_name_2/3) are set up, so none is home
    std::string token;     // long-lived access token (never logged)
    std::string pipeline;  // voice assistant name in Home Assistant ("" = its preferred one)
    bool followUp = true;  // listen again after each answer
    std::vector<std::pair<VoiceCommand, std::string>> extraPhrases;  // say.* from settings.txt
    std::string visionUrl;    // Ollama, for "what do you see?" ("" = no vision)
    std::string visionModel;  // e.g. gemma3:4b
    bool memory = true;       // "remember that ...": notes on the SD card, given to the AI
    bool learn = true;        // after a chat, the AI picks out lasting facts and adds them to the notes
    std::string voiceIdUrl;   // voice recognition service ("" = off): owner or someone else?
};

// What the UI should show, posted to the queue given to assistantStart().
struct AssistEvent {
    enum Type : uint8_t {
        Thinking,  // you stopped talking; it's working on it
        Command,   // you said a built-in action command: `command`
        Reply,     // the answer arrived: `emotion` ("" if none); speech starts playing
        Done,      // finished speaking
        NotHeard,  // no words recognized (`followUp`: it was a follow-up, so end quietly)
        Error,     // something failed (see the log); `text` says what
        WakeAgain, // you only said "Hey Buddy" (during a follow-up): it listens again
        Look,      // you asked about what it sees (`text`): take a photo, then assistantLook()
        LookSaved, // you asked about a photo it took (`text`): load the newest one, then assistantLook(..., saved = true)
    } type;
    bool followUp;
    int command;
    char emotion[16];
    char text[128];
};

// Starts the client in the background: waits for Wi-Fi, connects, logs in
// and looks up the voice assistant. Returns false if the settings are unusable.
bool assistantStart(const AssistantConfig& cfg, QueueHandle_t events);

bool assistantAvailable();   // connected, logged in, voice assistant found, not mid-turn
const char* assistantStatus();

// For voice.cpp. beginTurn returns false if a turn can't start now (then the
// offline command recognizer handles it). Audio is 16 kHz mono.
bool assistantBeginTurn(bool followUp);
void assistantAudio(const int16_t* pcm, int samples);
void assistantEndAudio(bool heardSpeech);
bool assistantSttDone();  // Home Assistant decided you stopped talking
// Recording a voice sample ("learn my voice"): listen patiently (longer to
// start, longer pauses allowed).
bool assistantWantsLongAnswer();

// "What do you see?": after a Look event (or the offline "what is this"
// command), the main loop takes a photo and hands it over here. Takes
// ownership of `jpeg` (PSRAM). The answer comes back like any other reply
// (Thinking, Reply + speech, Done). `fromConversation`: the request came
// from an AI conversation turn (the microphones are waiting for this to
// finish; follow-up questions about the photo then go to the vision model).
// Pass jpeg = nullptr if the photo couldn't be taken (it lets go of the turn).
// Says something on its own, not in answer to anything (e.g. "welcome back"):
// `text` may start with an emotion tag, like an AI reply. False if Home
// Assistant isn't connected or a conversation is going on.
bool assistantSay(const std::string& text);

bool assistantCanSee();  // vision is set up and Home Assistant is connected (to speak)
void assistantLook(uint8_t* jpeg, size_t len, const std::string& question, bool fromConversation,
                   bool saved = false);

// A photo was just taken and saved as `name` (e.g. "IMG_0007.jpg"): the vision
// model describes it in the background, for photonotes. Takes ownership of `jpeg`.
void assistantPhotoTaken(uint8_t* jpeg, size_t len, const std::string& name);
