ecstoneusps/Claude-gadget/(commit log)

2026-11-03 Add animated face engine, CoreS3 firmware, and desktop preview
    Portable face engine (lib/Face) with 9 tweened expressions, auto-blink,
    wandering gaze, breathing and talking mouth. CoreS3 firmware wires it to
    touch, IMU and mic loudness. Desktop preview renders PNG/GIF.
    Claude-Session: https://claude.ai/code/session_01Qqz4HFgsR6gFZLtHn8HrtA
2026-11-03 Add offline voice commands with ESP-SR; move firmware to ESP-IDF
    - "Hey Buddy" wake word (WakeNet) and 15 English commands (MultiNet7)
    running on-device via the audio front-end, fed from the CoreS3 mic
    - Behavior logic moved into a portable Companion component with native
    unit tests (tests/run_tests.sh)
    - Project switched from PlatformIO/Arduino to ESP-IDF so ESP-SR models
    are packed and flashed automatically; custom partition table adds an
    8 MB model partition
    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
    [partitions.csv]
2026-11-04 Add synthesized sound effects through the speaker; verify full ESP-IDF build
    - components/sfx: 12 procedurally synthesized effects (chirp, boop, happy,
    giggle, love, purr, sad, angry, surprised, confused, yawn, wake) with a
    loudness envelope used to lip-sync the mouth
    - Companion queues a sound for each reaction; new "be quiet" / "sound on"
    voice commands mute and unmute; purr and shake sounds are rate-limited
    - main/sound.cpp plays them on the CoreS3 speaker, pausing the voice
    pipeline and switching mic <-> speaker from the UI task
    - main no longer pins REQUIRES so managed components link; pin M5Unified
    ^0.2.29 (the version built against)
    - Firmware now builds end to end with ESP-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
    [Companion.cpp, Companion.h, main.cpp]
2026-11-04 CI: print resolved dependencies.lock in the log and run summary
    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
2026-11-04 Pin component versions with dependencies.lock from CI
    Resolved by the component manager in CI run #2 (ESP-IDF v5.4.1):
    esp-sr 2.6.1, esp-dl 3.3.14, M5Unified 0.2.29, M5GFX 0.2.36.
    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
2026-11-04 Wake up and greet you when you sit down (proximity sensor)
    - main/proximity.cpp: LTR-553 driver (register map from M5Stack's
    M5CoreS3 LTR5XX driver), configured for maximum range
    - PresenceDetector learns the empty-desk baseline and reports
    Arrived/Left on a sustained rise; ignores blips and slow drift, and
    re-learns if an object is parked next to the sensor
    - Companion: arriving wakes it (even after "good night") and greets you
    at most every 15 s; leaving makes it doze off after ~20 s
    - Raw readings logged every 10 s for tuning; 6 new unit tests
    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
    [Companion.cpp, Companion.h, Presence.cpp, Presence.h, main.cpp, proximity.cpp, proximity.h]
2026-11-04 Look toward your face using the CoreS3 camera
    - main/camera.cpp: GC0308 setup (pins from M5Stack's CoreS3 library) and a
    face-detection task on core 1 using Espressif's human_face_detect model
    (MSR+MNP, ~40 ms/frame); 5 fps awake, 1 fps dozing, paused when asleep
    - Camera and M5Unified share the internal I2C bus: M5Unified releases the
    port, the camera opens it with ESP-IDF's I2C driver, and M5GFX re-attaches
    as a foreign-bus user
    - components/espdl_all_ops: registers every esp-dl op so ESP-SR's op list
    doesn't strip ops the face model needs
    - Companion: eyes follow the face (after explicit look commands); seeing
    you again while dozing wakes and greets; never overrides "good nigh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
    [Companion.cpp, Companion.h, camera.cpp, camera.h]
2026-11-04 Update dependencies.lock for camera and face detection
    Adds esp32-camera 2.1.8, esp_jpeg 1.3.2 and human_face_detect 0.5.2 as
    resolved by CI run #6; existing versions unchanged.
    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
2026-11-04 Remember the mute setting across restarts
    Store it in the ESP32's flash key-value store (NVS) via a small
    main/settings module; loaded at boot and written only when "be quiet" or
    "sound on" changes it.
    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
2026-11-04 Add settings.txt on the microSD card
    - main/sdcard.cpp: mount the CoreS3's microSD (FAT32) on the display's
    SPI2 bus with CS on GPIO4; never formats the card
    - components/config: portable parser for a commented "name = value" file
    with per-line warnings; volume, brightness, sleep timers, command
    confidence, extra voice phrases (say.<command> = ...), camera, proximity
    and tilt options
    - First boot with a card writes a commented default settings.txt;
    sdcard/settings.txt in the repo is the same file (checked by a test)
    - Settings applied at startup to sound, display, Companion, presence,
    face tracking and the speech recognizer; FAT long file names enabled
    - 6 parser tests
    Co-Author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
2026-11-04 Add xiaozhi-compatible emotion vocabulary and 9 new expressions
    - New expressions: laughing, crying, embarrassed, shocked, thinking,
    winking, cool, relaxed, silly (18 total), built from new tweenable face
    params: per-eye openness, flat top lid, tears, tongue, mouth skew,
    horizontal gaze bias and laugh bounce
    - expressionForEmotion(): maps all 21 emotion names used by xiaozhi-esp32
    (MIT) AI servers to the closest expression
    - Companion::onEmotion(): shows a named emotion with a matching sound, the
    hook for a future AI connection
    - Voice commands: "wink at me", "be cool", "be silly"
    - 4 new tests; preview sheet and settings.txt regenerated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
2026-11-04 Full-duplex audio: listen while making sounds
    - main/audio_io.cpp: drive the CoreS3's ES7210 (both mics) and AW88298
    (speaker amp) together on I2S0 at 16 kHz with Espressif's esp_codec_dev,
    following xiaozhi-esp32's (MIT) CoreS3 approach; M5Unified's own mic and
    speaker are disabled
    - main/sound.cpp: player task streams effects in 16 ms chunks, newer
    sounds cut in; soundHeardRecently() lets main ignore its own sounds for
    clap/speech reactions
    - main/voice.cpp: feed the AFE straight from the stereo mic stream; the
    pause handshake is gone
    - main/i2c_bus.cpp: one ESP-IDF bus handle on the internal I2C port, shared
    by M5GFX, the camera (now via SCCB_Use_Port) and the audio codecs
    -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
2026-11-05 README: quote @flash_args so the flash command works in PowerShell
    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
2026-11-05 Voice: replace "be silly" (heard as "be sad" on the device)
    First hardware test: "be silly" was recognized as "be sad". Use the
    distinct "make a silly face" / "act goofy" instead, and add "do a wink"
    since "wink at me" took a few tries.
    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
    [Companion.cpp]
2026-11-05 Stay awake while you're there; camera diagnostics
    From the first hardware test: it dozed off while someone sat in front of
    it, and face tracking showed no effect.
    - Companion: a visible face or proximity presence keeps it awake; the
    sleep countdown starts once you've gone. A proximity "left" is ignored
    while the camera still sees you. 3 new tests.
    - camera.cpp: status line every ~10 s (frame size, detect time, faces
    found, mean green read both byte orders) whether or not a face is found
    - camera_preview = on (settings.txt) shows the camera image with a green
    box around a detected face instead of the face, to check the camera,
    colors/byte order, detection and mirroring by eye
    Co-A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
2026-11-05 Fix core 0 overload: split speech across cores, lighten camera
    Hardware log showed the idle-task watchdog firing every 5 s on core 0:
    sr_feed and sr_detect (dual-mic BSS + 2-channel wake word) plus the
    camera driver left it no idle time.
    - sr_detect (wake word + MultiNet in fetch) moves to core 1 at priority 5,
    above the UI; sr_feed (front-end) stays on core 0
    - Camera driver task on core 1 (CONFIG_CAMERA_CORE1) and captures only on
    request (1 frame buffer, GRAB_WHEN_EMPTY) instead of continuously
    - 30 s status line (audio, voice front-end, sd, camera, proximity,
    battery, free memory) so a log opened any time shows what started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
    [camera.cpp, main.cpp, voice.cpp, voice.h]
2026-11-05 Face detection: run on core 0 with fresh frames
    Hardware test: preview was slow and a face was only found after holding
    still for a minute. Detection ran at the lowest priority on core 1 next
    to wake word, commands and drawing, on stale frames (GRAB_WHEN_EMPTY).
    Move it to core 0 (priority 3, below the mic front-end), which has spare
    capacity since sr_detect moved off it, and go back to GRAB_LATEST with
    two frame buffers.
    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
2026-11-05 Fix permanent low-battery sleepiness; 160x120 camera frames
    Hardware log: battery reads 0% (no battery / not reported on USB), and
    "below 10% and not charging" kept it permanently sleepy. Low battery now
    requires running without USB power (VBUS < 4 V) and a level of 1-9%.
    Face detection took ~570 ms per frame (model ~40 ms nominal); the quad
    PSRAM is shared with the display buffer and speech models. Capture at
    160x120 (subsample mode keeps the full field of view), which is the size
    the detector's first stage works at anyway: a quarter of the camera's
    memory traffic. Preview pixel-doubles to fill the screen. Status line now
    shows the UI frame rate and USB voltage.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
    [camera.cpp, camera.h, main.cpp]
2026-11-05 Camera: mirrored by default (confirmed on CoreS3 hardware)
    Hardware test: with camera_mirrored = off the eyes moved away from the
    person, so the CoreS3's camera needs it on. Make that the default so a
    fresh card is right; regenerate sdcard/settings.txt. Mark the hardware
    bring-up done in the roadmap.
    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
2026-11-05 Face tracking: catch up faster; camera_mirrored back to off
    Hardware test: the direction was right after all; the eyes lagged so far
    behind that they looked reversed. Detection found the face in only some
    frames (dim image, motion blur), and the eyes waited for the next hit.
    - After a miss within 2 s of a sighting, retry immediately instead of
    waiting a full interval; normal rate once nobody is there
    - Eye smoothing trusts each new sighting more (0.8 instead of 0.5)
    - Camera log reports "face found in X of Y frames" and brightness
    - camera_mirrored default back to off (correct for the CoreS3)
    Claude-Session: https://claude.ai/code/s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
    [Companion.cpp, camera.cpp]
2026-11-05 Camera: brighten dark frames before face detection
    Hardware log: raw brightness 6-10/63 indoors; faces found in ~40% of
    frames sitting still and 8-30% moving. The quick retries also cost UI
    frame rate (23 -> 17 fps).
    - Highest auto-exposure target on the GC0308 (set_ae_level +2)
    - Software auto-brighten of each frame toward mean 28/63 (gain up to 4x)
    before detection; the preview shows the boosted image
    - Retry after a miss every 60 ms instead of 20 ms
    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
2026-11-05 Face detection: add the more accurate ESPDet-Pico model (default)
    Hardware log: even in bright light (brightness 23-24/63) the fast
    MSR+MNP model found the face in only 7-10 of 50 frames. Include Espressif's
    ESPDet-Pico 224 face model (published mAP 0.504 vs 0.367) and make it the
    default; settings.txt face_model = fast switches back. App now 3.3 MB of
    the 4 MB partition.
    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
2026-11-06 AI conversation through Home Assistant's voice assistant
    After "Hey Buddy", what you say streams over Home Assistant's websocket
    API (assist_pipeline/run) for speech-to-text. Built-in face and mood
    commands said on their own still run on the device; everything else goes
    to the conversation agent. The reply's leading emotion tag sets the face,
    and the rest is fetched as 16 kHz WAV (tts_get_url) and spoken with the
    mouth following its loudness. It then listens for a follow-up without the
    wake word. Falls back to the offline command recognizer when Home
    Assistant isn't reachable.
    - wifi.cpp: station with background reconnect
    - assistant.cpp: login, voice assistant lookup by name, turn state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
    [partitions.csv]
2026-11-06 Free internal RAM for Wi-Fi; throttle the accurate face model
    On hardware Wi-Fi failed with ESP_ERR_NO_MEM: after the speech and face
    models loaded there wasn't ~40 KB of internal RAM left. Frees ~55 KB:
    - camera DMA buffer 30 KB -> under 8 KB (CAMERA_DMA_BUFFER_SIZE_MAX)
    - Wi-Fi code out of IRAM (shares space with the heap): +17 KB
    - 6 static Wi-Fi RX buffers instead of 10 (BA window 6 to match)
    - assistant task stack in PSRAM, websocket task stack 6 -> 5 KB
    The accurate face model (~0.5 s per check) ran back to back on core 0
    and triggered the idle-task watchdog; it now always rests at least half
    as long as each check took.
    Also: the status line says why Wi-Fi is off ("FAILED: out of mem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
    [assistant.cpp, camera.cpp, wifi.cpp]
2026-11-06 Start Wi-Fi at boot, before the camera and models fragment internal RAM
    Hardware log: 50 KB internal RAM free but the largest block was 13 KB,
    and Wi-Fi's static buffers still failed to allocate. Wi-Fi now starts
    right after the settings load; the AI client still starts once the
    speech models are ready. Also: the face task's 12 KB stack moves to
    PSRAM, and only allocations up to 2 KB (was 4 KB) default to internal RAM.
    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
    [camera.cpp, main.cpp, wifi.cpp, wifi.h]
2026-11-06 Home Assistant login: send the token on connect
    Hardware: the status stayed at "ai logging in". ESP-IDF 5.4's websocket
    transport keeps bytes that arrive in the same packet as the handshake
    reply in its buffer, but its poll only watches the socket, so Home
    Assistant's immediate auth_required message was never delivered. Home
    Assistant then closed the connection after 10 s, and the client doesn't
    reconnect after a clean close by default.
    - send the token as soon as the connection opens; the reply is new data,
    which also flushes the buffered message
    - reconnect after Home Assistant closes the connection
    - log each login step, send failures, unreadable messages and the
    reason for disconnec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
    [assistant.cpp]
2026-11-06 Give core 1 a breather after each frame; fast face model by default
    Hardware: the first spoken AI replies work end to end. During a later
    reply the task watchdog reported IDLE1 starved: drawing the face takes
    ~58 ms per frame (17 fps) and the loop only paused 2 ms, so the reply
    download and other core-1 work left the idle task no time. The UI now
    rests 6 ms after each drawn frame.
    The accurate face model (ESPDet-Pico) takes ~450-640 ms per check on
    this board and slows the animation through shared PSRAM bandwidth; the
    fast model checks ~14 times a second and follows a face better overall.
    It's the default again (settings.txt face_model = accurate still works).
    CI artifacts now include the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
2026-11-06 settings.txt: add every missing setting on startup, not just the AI section
    A settings file written by an older version gets each setting it doesn't
    mention appended at its default value: a section missing entirely comes
    with its explanations, otherwise just the missing lines under the
    section's heading "(added by an update)". A commented-out setting counts
    as present, so a choice to leave it at the default isn't undone, and the
    file isn't appended to again on the next start.
    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
    [main.cpp]
2026-11-06 Louder: volume curve, speech boost, and "louder"/"quieter" by voice
    Hardware: at volume 85 replies were hard to hear beyond a foot.
    - Volume curve: esp_codec_dev's default spreads 0-100 linearly over
    50 dB, so 85 was 7.5 dB below the maximum. Now 50 = -16 dB,
    85 = -5 dB, 100 = maximum.
    - Spoken replies are processed for the small speaker: 250 Hz high-pass
    (bass it can't reproduce only wastes loudness), the speech raised to a
    steady level (up to +18 dB), and a soft limiter so peaks never clip.
    Portable and unit-tested (prepareSpeech in components/assist).
    - New action commands "louder / speak up / turn it up / volume up /
    talk louder" and "quieter / turn it down / volume down / ta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
2026-11-06 Speech processing in single precision; reply task above the UI
    Hardware (build #31): replies took 7-44 s to start and the idle-task
    watchdog fired on core 1 during each one. prepareSpeech used double
    precision, which the ESP32-S3 does in software, and the assistant task
    (priority 3, below the UI at 4) only ran in the UI's short pauses.
    - prepareSpeech: float throughout, x/(1+x) limiter instead of tanh
    (~0.5 ms for 8 s of audio on a PC); target -12 dBFS instead of -16,
    since replies already measured about -16 and got +0-1 dB
    - wavToMono: no resampling math when the audio is already 16 kHz
    - assistant task priority 5
    - a follow-up that's only "Hey Buddy" now counts as the wake word: it
    c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
    [assistant.cpp, assistant.h, main.cpp]
2026-11-06 Play replies while they stream in; don't wait for a late end-of-stream
    Measured on hardware (build #33): the reply audio's first byte arrives in
    0.25-0.7 s, but Home Assistant sometimes keeps the stream open long after
    the last audio (one 293 KB reply took 42.9 s to "finish", with core 1
    10% idle, i.e. just waiting). That, not the device, made replies start
    5-40 s late.
    - the reply audio now plays as it downloads (sound.cpp: streaming speech
    through an 8 s PSRAM buffer; the speaker plays silence on underrun)
    - once everything received has played and nothing new arrives for 2 s,
    the reply counts as finished and follow-up listening starts
    - SpeechShaper replaces prepareSpeech: the same fil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
    [assistant.cpp, sound.cpp, sound.h]
2026-11-06 LD2410 presence radar on Port C
    An HLK-LD2410(B/C) 24 GHz radar notices someone sitting still a metre or
    two away (the LTR-553 proximity sensor only sees ~20-30 cm) and works
    through thin plastic. When one is detected it takes over the
    arrived / left events from the proximity sensor.
    - components/ld2410: portable parser for its data frames (basic and
    engineering mode, resyncs after garbage, skips command replies), tests
    - RadarPresence (components/companion): at the desk = a target within
    radar_distance_cm for 0.8 s; left after 8 s without one
    - main/radar.cpp: UART1 at 256000 baud on Port C's pins (from M5Unified);
    swaps RX/TX by itself if the signal wires are crossed; a radar plugge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
    [Presence.cpp, Presence.h, main.cpp]
2026-11-06 Camera: pause face detection when the radar says nobody's there
    - with a working radar, face detection (~40% of core 0, plus PSRAM
    bandwidth the face animation competes for) stops while nobody is at
    the desk and resumes when the radar sees someone; logged on change
    - the camera isn't started at all when face_tracking and camera_preview
    are both off (it captured frames continuously even when unused)
    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
2026-11-07 Photos and seeing: "take a picture", "what do you see?"; two mics on core 0
    - "take a picture" (also inside longer sentences, and offline): the camera
    starts at 640x480 only for this, live view with a 3-2-1 countdown, a
    flash, the photo on screen, saved as photos/IMG_NNNN.jpg on the SD card
    - "what do you see / what am I holding / can you read this / how do I
    look...": a photo plus the question go straight to a vision model in
    Ollama (vision_url, vision_model; default gemma3:4b); the answer is
    spoken through Home Assistant like any reply, with its emotion tag.
    Follow-ups in the next minute ask about the same photo.
    - camera: photo mode pauses face tracking (if on) and restarts it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
2026-11-07 Fix photos: PSRAM DMA at 640x480, never block the screen; presence and radar fixes
    Hardware (build #37): "take a picture" showed "Say cheese! 3" frozen,
    then a white flash and no photo. The log had EV-EOF-OVF and repeated
    "Failed to get frame: timeout".
    - photo mode now has the camera DMA straight into the PSRAM frame
    buffers; the 8 KB internal DMA buffer (sized for Wi-Fi's sake)
    overflowed at 640x480. Falls back to 320x240 if no frames arrive.
    - the live view and capture never wait on the driver's 4 s frame
    timeout (esp_camera_available_frames); black until the first frame
    - PresenceDetector ignores the proximity sensor's 0 readings before its
    first measurement; learning 0 as the em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
    [Presence.cpp, camera.cpp, main.cpp, radar.cpp]
2026-11-07 Photos: halve the camera's pixel clock in photo mode
    Hardware (build #38): frames now complete at 640x480 with PSRAM DMA, but
    the live view showed wavy lines and scrambled colors, consistent with
    the camera's DMA losing bytes while the display and speech also use
    PSRAM. GC0308 register 0x28 (bits 6:4) divides the pixel clock; the
    driver sets it to /2 on the original ESP32 but not on the S3. Photo mode
    now sets /2 too, halving the camera's memory traffic (the live view runs
    at a lower frame rate, which is fine for aiming).
    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
2026-11-07 Photos at 320x240 through the normal DMA path, pixel clock /4
    Hardware (builds #38, #39): with "DMA straight into PSRAM" the 640x480
    frames had whole strips missing or holding old memory, with or without a
    halved pixel clock, so that mode isn't usable here. Photos now use the
    same normal DMA path as face tracking (which delivered clean frames for
    days) at 320x240, the screen's size, with the GC0308's pixel clock
    divided by 4 so the 8 KB DMA buffer sees no more data per second than it
    does for tracking. The divider register is read back into the log.
    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
    [camera.cpp, camera.h]
2026-11-07 photo_flash setting: light the scene with the screen while a photo is taken
    With photo_flash = on the screen goes white at full backlight, the frames
    already buffered (and the next, possibly half-lit one) are skipped, and
    the photo is a frame exposed under the flash; the brightness is restored
    afterwards. Off (default) keeps the white screen as just the "click"
    after the photo, since shiny things reflect the flash.
    Also warn in the log if new settings couldn't be added to settings.txt.
    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
    [camera.cpp, camera.h, main.cpp]
2026-11-07 Face: clear and send only the part of the screen that changed
    The face covers the middle of the screen, but every frame cleared all
    320x240 pixels of the PSRAM sprite and sent all 150 KB to the display,
    which with drawing kept core 1 ~87% busy at 16 fps.
    - DirtyCanvas (components/face, header-only): wraps the face's canvas,
    tracks the area drawn this frame and last, makes fillScreen() clear only
    last frame's area, and reports the union to send. invalidateAll() after
    a photo or camera preview covered the screen.
    - main: pushes the sprite through a clip rectangle (M5GFX sends only the
    clipped window), and logs average draw / send time and changed area
    every 30 s.
    - test: 4000 frames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
2026-11-07 Puppy body: printable parts (head, back cap, ears, body) with pink inlays
    A chibi sitting puppy for the CoreS3 + DIN base, remixed from John White's
    "Puppy Stand - M5Stack Core S3" (CC BY 4.0):
    - head: front lip and side/bottom openings where the original has them,
    an 18 mm dome chamber above Ports B/C for Grove plugs, an 8 mm gap behind
    the CoreS3 leading into the neck; the CoreS3 slides in from the back
    - back cap: groove over a rim on the head, prints flat side down
    - floppy ears with pink inner-ear inlays, printed flat, tab + slot joint
    - body: hollow with a 45-degree inside ceiling (no supports inside), oval
    neck that fits a socket under the head, grooved rails in the chest for an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
    [buddy_back_cap.stl, buddy_body.stl, buddy_body_pink.stl, buddy_ear_left.stl, buddy_ear_left_pink.stl, buddy_ear_right.stl, buddy_ear_right_pink.stl, buddy_head.stl]
2026-11-07 Puppy head: print upright for a smooth dome
    Test print (face down) fit the CoreS3 well, but the front half of the dome
    was an overhang and printed rough. The head now prints standing on its
    bottom, as assembled:
    - bottom edges are a 45-degree chamfer (no overhang at the bed)
    - the chamber above the CoreS3 has a 45-degree roof from the sides and
    front (17-18 mm left above Ports B and C), so nothing inside needs
    supports; ~25 mm internal bridge at the top
    - outside: no surface steeper than 45 degrees; bridges over the screen
    window (50 mm), side windows (13.5 mm) and ear slots
    - inside dimensions and openings unchanged (confirmed by the fit test)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
    [buddy_back_cap.stl, buddy_ear_left.stl, buddy_ear_left_pink.stl, buddy_ear_right_pink.stl, buddy_head.stl]
2026-11-08 Puppy back cap: ribs hold the CoreS3, looser rim fit, prints back side down
    Test fit: the CoreS3 slid front to back (nothing behind it), and the head
    and cap needed trimming to fit.
    - two ribs on the cap reach forward and hold the CoreS3 against the front
    lip (0.2 mm play), at the left and right edges, clear of the cables
    - the rim/groove is a U around the pocket only (left, bottom, right); in
    the dome the chamber narrows toward the back and a rim there stepped
    - rim clearance 0.25 -> 0.35 mm, with a 0.5 mm lead-in on the rim
    - the cap prints back side down so the groove is away from first-layer
    squish (and the ribs can print); the head's back edges get the same
    45-degree chamfer as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
    [buddy_back_cap.stl, buddy_ear_left.stl, buddy_ear_left_pink.stl, buddy_ear_right.stl, buddy_ear_right_pink.stl, buddy_head.stl]
2026-11-08 Puppy voice: barks, yips and panting as the default sound style
    sound_style = puppy | robot in settings.txt; sounds/<name>.wav on the SD card
    replaces any built-in sound; the mouth follows the actual playing level.
    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
    [Companion.cpp, Companion.h]
2026-11-08 Puppy back cap: crush ribs grip the head's rim, longer ribs reach the recessed back panel
    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
    [buddy_back_cap.stl]
2026-11-08 Puppy back cap: screw it to the DIN base's brass nuts; ribs reach the 28 mm panel
    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
    [buddy_back_cap.stl]
2026-11-08 Puppy back cap: screw holes 23.5 mm apart, slotted to fit 23-24 mm
    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
    [buddy_back_cap.stl]
2026-11-08 Puppy back cap: screw it to the head's side walls (drilled through the cap)
    The friction fit never held, and the DIN-base screws only tie the cap to the
    CoreS3. Two M3 screws now go through the cap into the head's 8 mm side walls;
    pilot holes are drilled through the cap, so the head isn't reprinted. Drops the
    crush ribs (they kept the cap ~1 mm off) and gives the posts 0.5 mm of play.
    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
    [buddy_back_cap.stl]
2026-11-08 Puppy back cap: drop the side ribs (they held the cap ~1 mm off the head)
    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
    [buddy_back_cap.stl]
2026-11-08 Puppy back cap: clearance holes for the side screws
    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
    [buddy_back_cap.stl]
2026-11-08 Puppy back cap: posts 0.5 mm shorter so the cap seats without straining the screws
    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
    [buddy_back_cap.stl]
2026-11-08 Puppy v2: shorter head, all-screw joints, support-free body, real radar holder
    - Head 7 mm shorter (less room above the CoreS3), chamber ceiling of 45-degree
    slopes and a short bridge; ears' tabs moved clear of the pocket.
    - Neck moved forward so the back cap no longer covers its socket; two M3 x 10
    countersunk screws hold the head to the neck through the pocket floor.
    - Back cap: thicker, with the cap->head screws' heads sunk in counterbores and
    printed pilot holes in the head (no drilling).
    - Body: every underside slopes at 45 degrees or less to the bed, tail lies on
    the floor; radar board drops in through the neck into grooved cheeks.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
    [buddy_back_cap.stl, buddy_body.stl, buddy_body_pink.stl, buddy_ear_left.stl, buddy_ear_left_pink.stl, buddy_ear_right.stl, buddy_ear_right_pink.stl, buddy_head.stl]
2026-11-09 Puppy v3: CoreS3 turned around, smaller rounder head, regular M3 screws
    Hardware:
    - The CoreS3 goes in turned around (camera at the top), so Ports B/C face down
    over the floor opening and the radar cable plugs straight in from the neck.
    - Head smaller and rounder: 6 mm sides, rounded top corners, little room above
    the CoreS3 (nothing plugs in at the top now); 67 x 73 mm instead of 71 x 78.
    - Floor 2.5 mm thicker. Neck screws are regular M3 x 12 socket head, driven up
    from under the body through the neck into blind pilots in the floor, so the
    head goes on last with the cable already plugged in. Cap-to-head screws move
    to the floor's bottom corners. A cut-out skin over the floor open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
    [buddy_back_cap.stl, buddy_body.stl, buddy_ear_left.stl, buddy_ear_left_pink.stl, buddy_ear_right.stl, buddy_ear_right_pink.stl, buddy_head.stl]
2026-11-09 Puppy head: square front edges so the CoreS3 sits flush; wider port opening
    - The ceiling's front slope starts at the front wall again, and the pocket's
    edges around the front are square: the rounded top-front edge held the top
    of the CoreS3 off the front lip.
    - The floor opening is 34 x 16 mm so Ports B and C and their plugs fit; the
    neck screws move to the neck's back wall (neck 2 mm deeper) to make room.
    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
    [buddy_back_cap.stl, buddy_body.stl, buddy_head.stl]
2026-11-09 Docs: cut the latch off Grove plugs for the CoreS3's ports
    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
2026-11-09 Radar: check the ports' 5 V, try other baud rates, say whether anything is heard
    Without a battery, M5Unified can leave the CoreS3's port power off; switch it
    on again at start and log the result. While searching, count raw bytes so the
    log can tell "no power" from "wrong wiring/speed", and try the LD2410's other
    baud rates with both wirings.
    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
    [radar.cpp]
2026-11-09 Radar: remember the speed and wiring that worked, start with them next time [skip ci]
    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
    [radar.cpp, settings.cpp, settings.h]
2026-11-09 Puppy body: paw pads set flush into the paws (they floated after the paw reshape) [skip ci]
    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
    [buddy_back_cap.stl, buddy_body.stl, buddy_body_pink.stl, buddy_head.stl]
2026-11-10 Welcome back: say hello out loud after a long absence; remember the radar's speed
    - welcome_back_minutes (default 20, 0 = off): when the radar (or proximity
    sensor) sees you return after at least that long, Buddy speaks a greeting
    through Home Assistant, picked by how long you were gone. Not while muted
    or mid-conversation. assistantSay() speaks text on its own.
    - Includes the earlier change: the radar's baud rate and wiring are saved and
    tried first at the next start.
    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
2026-11-10 Notes: M5Stack StackChan parts and code, for motorizing Buddy someday [skip ci]
    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
2026-11-10 Speak while the AI writes; learn from chats; notes on the settings page
    - Streaming speech: intent-progress text deltas are split into sentences
    (sentenceEnd, unit-tested) and spoken one by one by a new speaker task, so
    speech starts while the AI is still writing; a reply that arrives whole is
    split the same way. The next sentence is fetched while the current plays.
    - Learning: ~90 s after a chat goes quiet, the AI is asked (its own one-off
    conversation) for lasting facts; parseLearnedFacts (unit-tested) turns them
    into notes. learn = off disables it.
    - Settings page: a second editor for memories.txt (same tap to accept).
    - README: speaking sooner, Kokoro voice setup, learning.
    Co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
2026-11-11 Eyes for the chat AI: [look] and [photo] tags; photos remembered
    - New conversations tell the AI it can see: replying [look] makes Buddy take a
    photo and ask the vision model the question ("how many fingers am I holding
    up?"); [photo] shows it the newest saved photo again. What he saw is passed
    back into the chat. More look phrases recognized directly.
    - Photos he takes are described by the vision model in the background (a new
    describer task); descriptions are saved as photos/IMG_NNNN.txt and the newest
    five go to the AI (photonotes).
    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
2026-11-11 Screen text: each screen sets its own font and size
    The photo countdown left the canvas text enlarged, so the settings prompt drew
    far too big; the newer screens left their font set for the photo captions.
    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
    [main.cpp]
2026-11-12 Home Assistant over MQTT: Buddy as a device with sensors and controls
    MQTT discovery (Mosquitto) creates "Desk Buddy": at desk, radar distance/
    movement/strengths, light level (now read from the LTR-553's ALS), sound level,
    someone talking, mood, awake, an interaction event (tapped, petted, shaken,
    wake word), volume/brightness/mute controls, a Say text entity, photo/sleep/
    wake buttons, and diagnostics. States are sent on change and once a minute;
    commands are carried out by the UI task. mqtt_url/mqtt_user/mqtt_password in
    settings.txt (password masked on the settings page).
    Claude-Session: https://claude.ai/code/session_01Qqz4HFgsR6g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
2026-11-13 Stop the AI fixating on photo contents: descriptions only for photo questions
    The newest photos' descriptions went to every conversation, and a small model
    worked them ("black shirt") into every answer. They now go along only when
    the question mentions a picture or photo. Learning also skips clothing,
    looks and photo contents.
    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
    [assistant.cpp]
2026-11-13 Know the owner's voice: voice ID service on the PC, guests not called by the owner's name
    - tools/voiceid: a small FastAPI service (SpeechBrain ECAPA) that enrolls the
    owner's voice and scores each question (owner / other / unsure).
    - Buddy keeps each question's audio, has it checked while speech-to-text runs,
    and tells the AI who is talking. "Learn my voice" records three samples as
    follow-ups; "forget my voice" resets (owner only).
    - "This is my friend Sarah" / "it's me" set who's talking for the
    conversation (parseSpeakerIntro, unit-tested); the owner's name comes from
    the notes. Learning labels guest lines so their facts aren't saved as yours.
    - voice_id_url setting.
    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
    [assistant.cpp]
2026-11-13 Learn my voice: record samples patiently, without speech-to-text; ask again
    The first sample ended 1.4 s in (a 1 s pause, or noise, ended it), Home
    Assistant found no words, and Buddy stopped listening without a word.
    Samples are now just recorded (no speech-to-text): up to 10 s to start,
    2 s pauses allowed, and if nothing was heard he asks again (twice) before
    giving up out loud.
    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
    [assistant.cpp, assistant.h, voice.cpp]
2026-11-13 Learn my voice: ignore the echo of his own question
    Recording started 0.25 s after he spoke; the echo of his voice counted as the
    answer, ended it ~1 s later and drew "too short", whose echo did it again.
    The first 0.8 s of a sample now isn't counted as speech and is cut from the
    sample, and a short sample is first re-listened quietly.
    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
    [assistant.cpp, voice.cpp]
